Rowansdabomb/ELEC491-CAPSTONE-/PCBs/Altium/Images/8x8_ir_pt_proposed.PNG

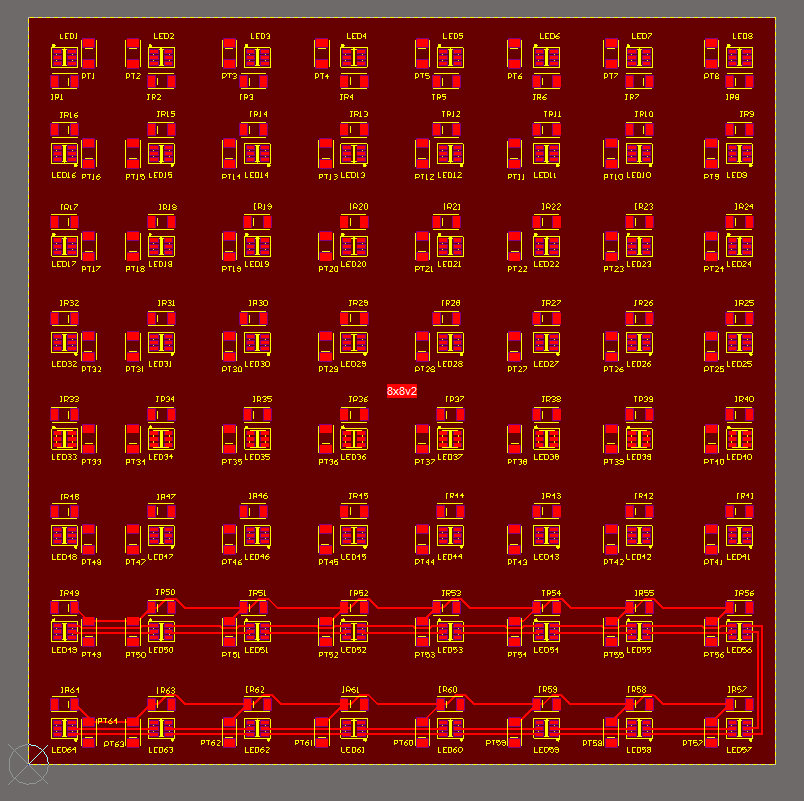
PCBs/Altium/Images/8x8_ir_pt_proposed.PNG
