Rowansdabomb/ELEC491-CAPSTONE-/PCBs/Altium/Images/8x8_with_7x7.PNG

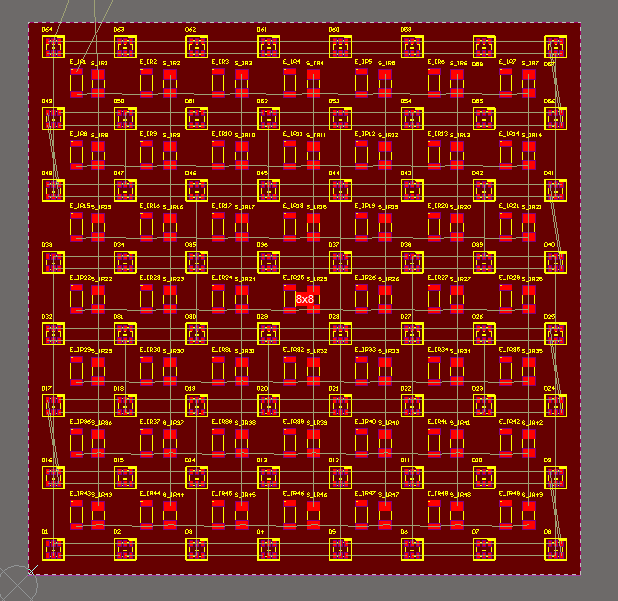
PCBs/Altium/Images/8x8_with_7x7.PNG
