Rowansdabomb/ELEC491-CAPSTONE-/PCBs/Altium/Images/incomplete_8x8_pcb.PNG

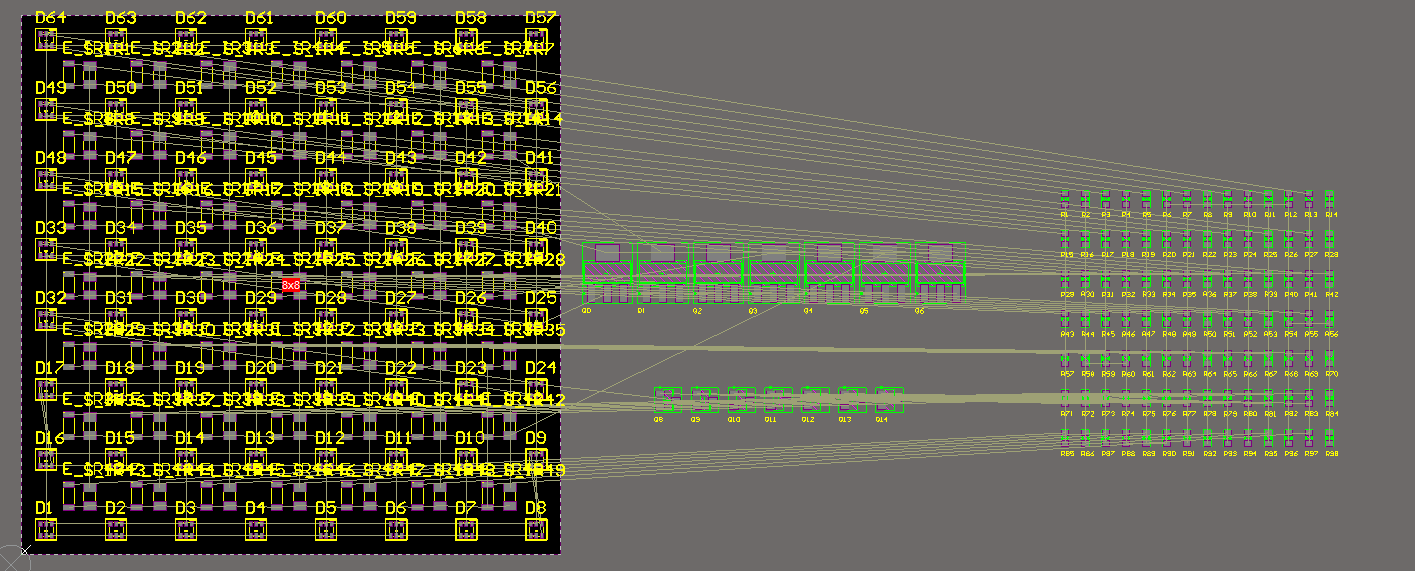
PCBs/Altium/Images/incomplete_8x8_pcb.PNG
