Rowansdabomb/ELEC491-CAPSTONE-/PCBs/Altium/Images/incomplete_8x8_sch.PNG

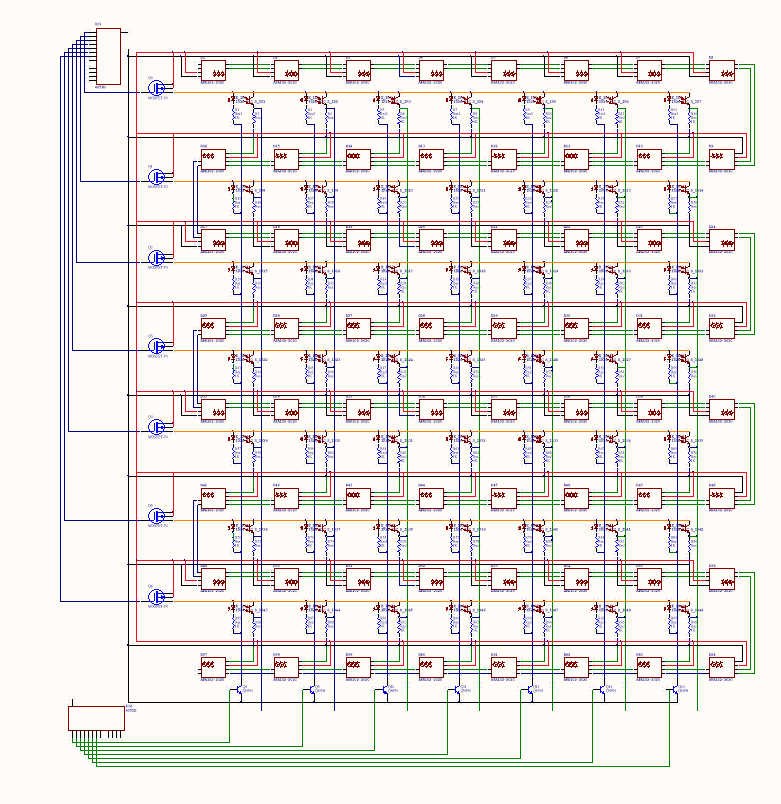
PCBs/Altium/Images/incomplete_8x8_sch.PNG
