Rowansdabomb/ELEC491-CAPSTONE-/(list of files, drawings)

Other design files:
PCBs/Altium/8x8.PcbDoc
PCBs/Altium/8x8.PrjPcb
PCBs/Altium/8x8.SchDoc
PCBs/Altium/8x8v2.PcbDoc
PCBs/Altium/8x8v2.SchDoc
