Rowansdabomb/ELEC491-CAPSTONE-/Code/Master/Master.ino

/***************************************************************************************
*  Title: Topology Test Master
* Author: Jimmy Wong, Rowan Baker-French, Sanket Mittal
* Date: February 10, 2019
* Code version: 0.1.0
***************************************************************************************/

#include <Wire.h>
#include "T25Setup.h"
#include "T25Tile.h"
#include "T25MasterTile.h"
#include "T25Common.h"
#include <string.h>

volatile bool newFrameFlag;
void newFrame();

void sensorRead();

HardwareTimer fpsTimer(2); // timer for updating the screen (send i2c data)
HardwareTimer sensorTimer(3); // time for polling the sensors

MasterTile master(0xFF);

void setup() {
  afio_cfg_debug_ports(AFIO_DEBUG_NONE);
  // Flag initialization
  newFrameFlag = false;
  // // Serial Setup - for output
  // Serial.begin(115200); 

  ///////////////// TILE BEGIN /////////////////////
  master.beginMasterTile();

  ///////////////// MATRIX FPS TIMER SETUP ////////////////////
  fpsTimer.pause();

  fpsTimer.setPeriod(1000*1000/master.getFrameRate()); // in microseconds

  fpsTimer.setChannel1Mode(TIMER_OUTPUT_COMPARE);
  fpsTimer.setCompare(TIMER_CH1, 1);  // Interrupt 1 count after each update
  fpsTimer.attachCompare1Interrupt(newFrame);

  fpsTimer.refresh();

  fpsTimer.resume();

  ///////////////// SENSOR POLL TIMER SETUP ////////////////////
  sensorTimer.pause();

  sensorTimer.setPeriod(SENSOR_POLL_PERIOD); // in microseconds

  sensorTimer.setChannel1Mode(TIMER_OUTPUT_COMPARE);
  sensorTimer.setCompare(TIMER_CH1, 1);  // Interrupt 1 count after each update
  sensorTimer.attachCompare1Interrupt(sensorRead);

  sensorTimer.refresh();

  sensorTimer.resume();
  ///////////////////////////////////////////////////

  master.setOperationMode(SCROLL_MODE); 
  // master.setOperationMode(SCROLL_MIRROR_MODE);
  // master.setOperationMode(AMBIENT_MODE);
  // master.setOperationMode(MIRROR_MODE);
  
}

void loop() {
  master.readSensorData();

  if(newFrameFlag) {
    master.handleDisplayShape();
    
    if (master.currentFrame % (master.getFrameRate()) == 0) {
      master.updateFromDataBase();
    }

    if (master.currentFrame % (master.getFrameRate() / master.getTargetFrameRate()) == 0) {
      for(uint8_t i = 0; i < master.getTileCount(); ++i) {
        char dataOut[MAX_DISPLAY_CHARS];

        struct POS outPos = master.getOutputData(dataOut, i);
        
        uint8_t tileID = master.getOrderedTileID(i);

        if (tileID == MASTER_TILE_ID) {
          master.updateTileDisplay(outPos, dataOut);
        } else {
          struct TILE slave = master.getTile(tileID);
          master.transmitToSlave(slave.addr, outPos, dataOut);
        }
      }
      master.updateScrollPos();
    }

    newFrameFlag = false;
  }
}

/*
Interrupt Subroutine on a timer.
Toggles the newFrameFlag at a frequency of master.frameRate
*/
void newFrame() {
  ++master.currentFrame;
  if (master.currentFrame > 30) master.currentFrame = 1;
  newFrameFlag = true;
}

void sensorRead() {
  master.ISR_sensorRead();
}
