Rowansdabomb/ELEC491-CAPSTONE-/Code/Final/T25Lib/T25Lib.h

#ifndef t25_t25_lib_h
#define t25_t25_lib_h

#include "Arduino.h"
#include "MasterTile.h"
#include "SlaveTile.h"
#include "Tile.h"


#include "Constants.h"
#include "PinConfig.h"
#include "Colors.h"

#endif
