Rowansdabomb/ELEC491-CAPSTONE-/Code/T25Lib/T25MasterTile/T25MasterTile.h

/***************************************************************************************
*  Title: Topology Test Master
* Author: Rowan Baker-French
* Date: March 3, 2019
* Code version: 0.0.1
***************************************************************************************/

#ifndef t25_master_tile_h
#define t25_master_tile_h

#include <Arduino.h>
#include "MasterTile.h"

#endif
