Rowansdabomb/ELEC491-CAPSTONE-/Code/T25Lib/T25Setup/T25Setup.h

/***************************************************************************************
*  Title: Topology Test Master
* Author: Rowan Baker-French
* Date: March 3, 2019
* Code version: 0.0.1
***************************************************************************************/

#ifndef t25_setup_h
#define t25_setup_h

#include <Arduino.h>
#include "Colors.h"
#include "Constants.h"
#include "MatrixSetup.h"
#include "PinConfig.h"

#endif 
