Rowansdabomb/ELEC491-CAPSTONE-/(commit log)

2018-11-09 Added initial I2C Test files
2018-11-09 Testing for 2 Slave boards with led line
2018-11-16 scrolling text in for 4 4x4 test pcb
2018-11-18 8 LEDs controlled by two mcus, sometimes freezes when reseting
2018-11-21 ir sensor test code
2018-11-22 add time tests, update sensor test
2018-11-22 ir sensor finger test
2018-11-25 add upated sensor test file
2018-11-26 Create I2C_DynamicAddress_Master
2019-01-23 add pcb to repo
    [8x8.PcbDoc, 8x8.PrjPcb, 8x8.SchDoc, 8x8v2.PcbDoc, 8x8v2.SchDoc]
2019-01-24 fix LED layout, start routing on bottom
    [8x8v2.PcbDoc, 8x8v2.SchDoc]
2019-01-25 add LED traces
2019-01-25 LED data and clk routes, vias to termination and on GND pins.
    [8x8v2.PcbDoc]
2019-01-25 Row 1 to 3 and some VCC vias added
    [8x8v2.PcbDoc]
2019-01-25 bottom layer readjust
    [8x8v2.PcbDoc, 8x8v2.SchDoc]
2019-01-25 more bottom layer layout changes
    [8x8v2.PcbDoc]
2019-01-26 straight lines for columns
    [8x8v2.PcbDoc]
2019-01-26 add more vias
    [8x8v2.PcbDoc]
2019-01-27 schematic resistor changes changes
    [8x8v2.PcbDoc]
2019-01-27 updated schematic resitstors
    [8x8v2.SchDoc]
2019-01-29 Checking and fixing for DRC errors 80% done
    [8x8v2.PcbDoc, 8x8v2.SchDoc]
2019-01-29 move pogo pads closer to edges
    [8x8v2.PcbDoc]
2019-01-30 DRC errors 95% fixed.
    [8x8.PrjPcb, 8x8v2.PcbDoc, 8x8v2.SchDoc]
2019-01-30 updated pad sizes
    [8x8v2.PcbDoc, 8x8v2.SchDoc]
2019-01-31 updated components, partial DRC fixes:
    [8x8.PrjPcb, 8x8v2.PcbDoc, 8x8v2.SchDoc]
2019-01-31 move VCCs off 18V
    [8x8v2.PcbDoc]
2019-02-01 add caps, fix more vias
    [8x8v2.PcbDoc, 8x8v2.SchDoc]
2019-02-02 add 2x20 headers
    [8x8v2.GBL, 8x8v2.GBO, 8x8v2.GBP, 8x8v2.GBS, 8x8v2.GTL, 8x8v2.GTO, 8x8v2.GTP, 8x8v2.GTS]
2019-02-04 Added code to distinguish between address change and LED data
2019-02-06 update PCB with 2x20 headers
    [8x8.PrjPcb, 8x8v2.PcbDoc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]
2019-02-06 fix via DRC's
    [8x8v2.PcbDoc]
2019-02-06 generate gerbers
    [8x8v2.DRL, 8x8v2.GBL, 8x8v2.GBO, 8x8v2.GBS, 8x8v2.GM1, 8x8v2.GTL, 8x8v2.GTO, 8x8v2.GTP]
2019-02-06 clean up some nets
    [8x8.PrjPcb, 8x8v2.PcbDoc]
2019-02-06 updated gerbers
    [8x8.PrjPcb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]
2019-02-06 removed voltage regulator from pcb
    [8x8.PrjPcb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]
2019-02-09 code for ISR poll scan of 8x8 sensor matrix
2019-02-09 fix topological pogos
    [8x8v2.PcbDoc, 8x8v2.SchDoc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]
2019-02-09 fixed header positioning to 700mil
    [8x8v2.PcbDoc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]
2019-02-12 few pcb updates
    [8x8v2.SchDoc]
2019-02-12 Added a flowchart to my Mapping Algo slide
2019-02-12 add i2c scroll code
2019-03-12 Update Slave.ino
    Preliminary code for Slave Tile with Scrolling *TODO* move functions into header and shorten main loop
    [Slave.ino]
2019-03-17 fix char width, separate master slave and tile libraries
    [Colors.cpp, Colors.h, Constants.h, Master.ino, MasterTile.cpp, MasterTile.h, MatrixSetup.h, PinConfig.h]
2019-03-20 integrate esp32 code and sensor poll code with Tile
2019-03-29 Temporary fix for when adding more than 1 tile
    [Master.ino]
2019-04-01 working sensor poll post pcb rework
    [Constants.h, Master.ino, Tile.cpp]
2019-04-03 sensor testing
2019-04-03 HotFix for Master communicating with STM32WIFI
2019-04-05 update 8x8 to final code only
    [8x8v2.PcbDoc]
2019-04-10 scroll mode is no longer working
    [Master.ino, MasterTile.cpp, MasterTile.h, Slave.ino, SlaveTile.cpp, Tile.cpp]
2019-04-11 working stm32 code'
